TheUndefinedEngineer/register-level-programming/Snapshots/Version 3/v3.0.3.jpg

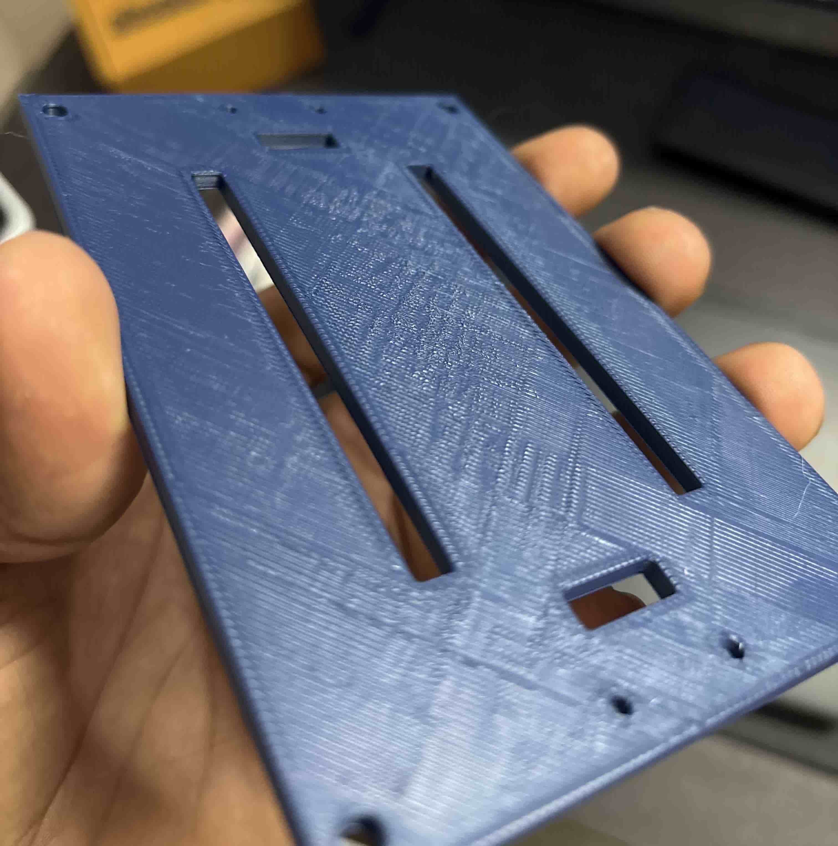
Snapshots/Version 3/v3.0.3.jpg
