TheUndefinedEngineer/register-level-programming/Snapshots/Version 3/v3.0.5.jpg

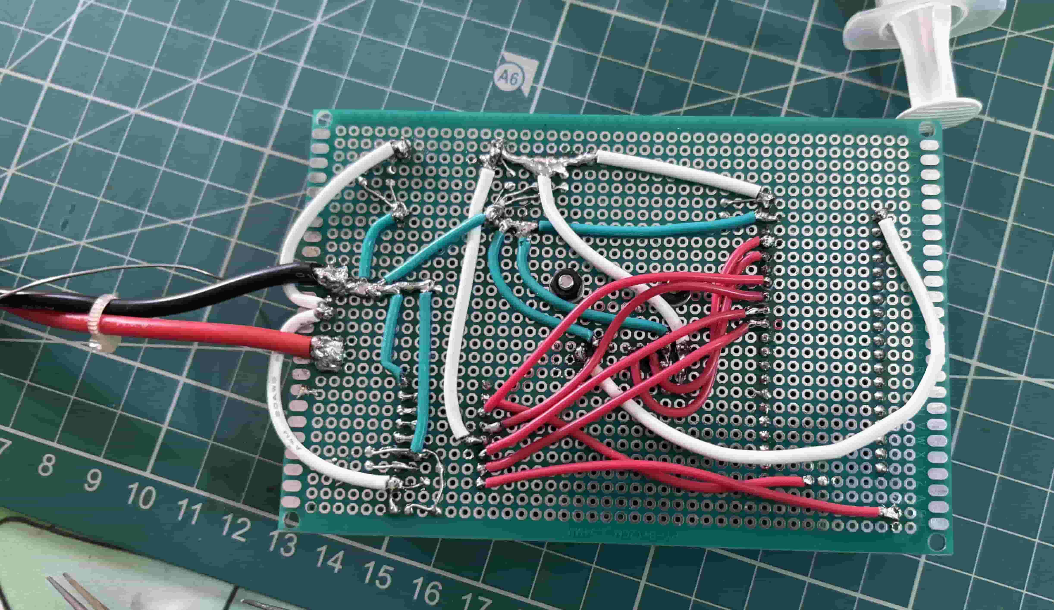
Snapshots/Version 3/v3.0.5.jpg
