TheUndefinedEngineer/register-level-programming/(commit log)

2026-04-29 Added hardware used and pin configuration in readme
2026-05-01 Modified so all pin connections are displayed in one table
2026-05-06 bug fix - moved code inside main()
    [main.c]
2026-05-27 fix: atomic operation on bsrr
    [main.c]
